TexZK/RATT/README.txt

RATT - Relatively Accurate TurnTable

For information about the project, please refer to:
./doc/reports/Report.pdf
