TexZK/RATT/doc/schematics/README.txt

PDF printings of the electronic schematics and PCB boards.
