TexZK/RATT/src/schematics/README.txt

Source code for PCB schematics, developed with CadSoft EAGLE 6.2.0.

http://www.cadsoftusa.com/eagle/
