TexZK/RATT/src/firmware/README.txt

Firmware source code, for a Microchip PIC18LF14K50.
Developed with MPLAB IDE 8.x, for the Microchip C18 v3.36 compiler.

http://www.microchip.com/mplab

USB library adapted from the "HID Simple Custom Demo" provided with the
Microchip Application Libraries, using the USB Framework v2.9d.

http://www.microchip.com/mal
