TexZK/RATT/tools/hidtrace/README.txt

HID Trace tool taken from the Atomix Virtual DJ wiki.

http://www.virtualdj.com/wiki/ControllerDefinitionHID.html
http://www.virtualdj.com/download/hidtrace.exe
