TexZK/RATT/src/schematics/report/README.txt

Source code for schematics used only inside the technical report.
