TexZK/RATT/src/report/images/ratt_placement.pdf

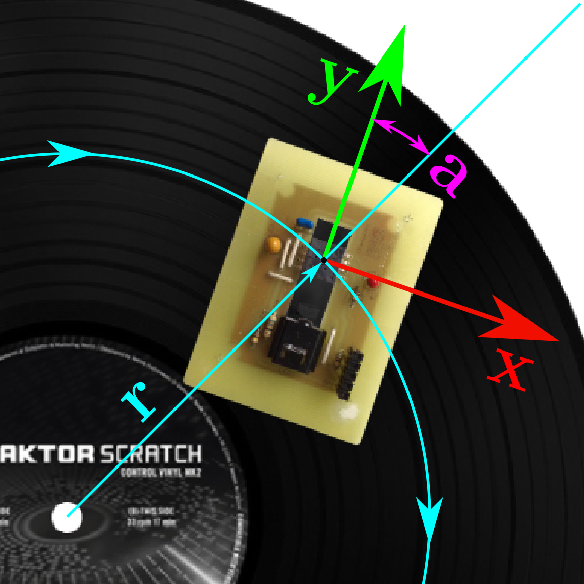
[picture p20: figure]
