TexZK/RATT/src/report/images/computations.xls

Sheet: Computations
Name | Description | Value | Unit
ttDiscDiam | Disc diameter | 12 | in
ttNomAngSpeed | Nominal angular speed | 33 | rot/min
ttPitchOff | Pitch offset | 0.00% | 1%
ttDiscPerim | Disc perimeter | 37.70 | in
ttAngSpeed | Angular speed | 33.00 | rot/min
ttRevRate | Revolution rate | 0.55 | Hz
ttRevTime | Revolution time | 1.82 | s
ttTgSpeed | Tangential speed | 20.73 | in/s
Name | Description | Value | Unit
ssRes | Resolution | 2000 | dot/in
ssMaxSpeed | Maximum speed | 30 | in/s
ssMaxDotRate | Maximum dots rate | 60000 | dot/s
ssMaxDotsOneMs | Maximum dots in 1 ms | 60 | dot
Name | Descritpion | Value | Unit
mmRadius | Radius | 4.00 | in
mmAngleOff | Angle offset | 0 | °
mmRadiusCm | Radius [cm] | 10.16 | cm
mmPerim | Measurement perimeter | 25.13 | in
mmSpeed | Speed | 13.82 | in/s
mmDotRate | Dots rate | 27646.01535 | dot/s
mmRevDots | Revolution dots | 50265.48246 | dot

Sheet: LaTeX data
\newcommand{\ | <-- Head
}{ | <-- Middle
} | <-- Tail
\newcommand{\ttDiscDiam}{ | 12.00 | }
\newcommand{\ttNomAngSpeed}{ | 33.00 | }
\newcommand{\ttPitchOff}{ | 0.00 | }
\newcommand{\ttDiscPerim}{ | 37.70 | }
\newcommand{\ttAngSpeed}{ | 33.00 | }
\newcommand{\ttRevRate}{ | 0.550 | }
\newcommand{\ttRevTime}{ | 1.818 | }
\newcommand{\ttTgSpeed}{ | 20.73 | }
\newcommand{\ssRes}{ | 2000 | }
\newcommand{\ssMaxSpeed}{ | 30 | }
\newcommand{\ssMaxDotRate}{ | 60000 | }
\newcommand{\ssMaxDotsOneMs}{ | 60 | }
\newcommand{\mmRadius}{ | 4.00 | }
\newcommand{\mmAngleOff}{ | 0.00 | }
\newcommand{\mmRadiusCm}{ | 10.16 | }
\newcommand{\mmPerim}{ | 25.13 | }
\newcommand{\mmSpeed}{ | 13.82 | }
\newcommand{\mmDotRate}{ | 27646.01535 | }
\newcommand{\mmRevDots}{ | 50265.48246 | }
