TexZK/RATT/src/report/images/hercules_mp3e2_schematic.jpg

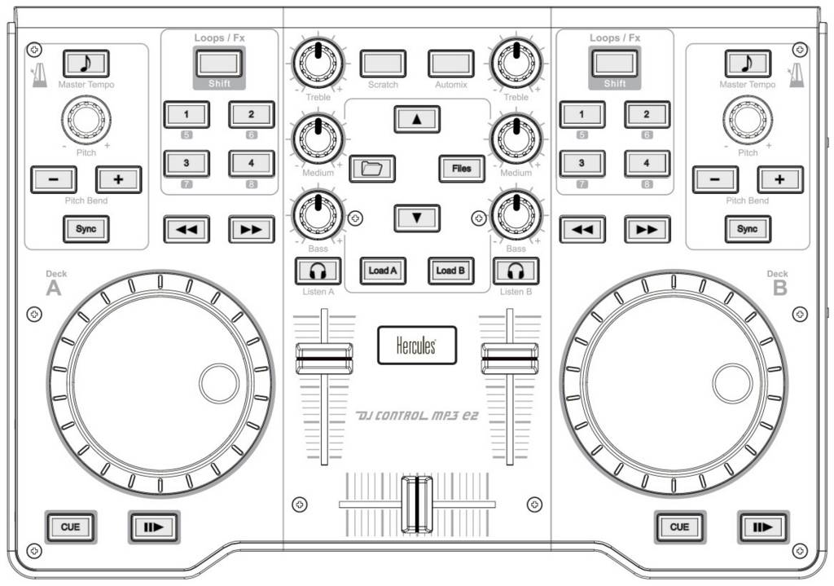
src/report/images/hercules_mp3e2_schematic.jpg
