TexZK/RATT/src/report/images/ratt_placement_merged.png

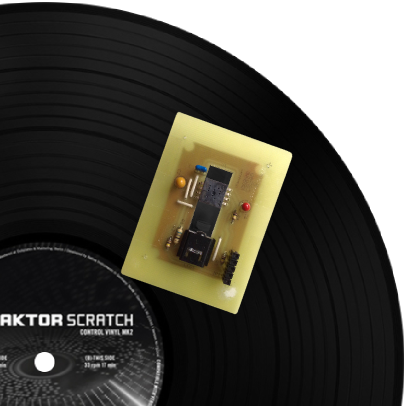
src/report/images/ratt_placement_merged.png
