TexZK/RATT/src/report/images/sensor_photo_float.png

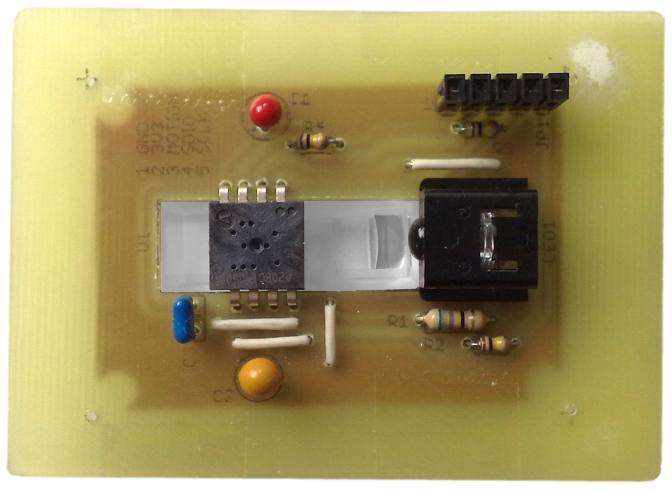
src/report/images/sensor_photo_float.png
