TexZK/RATT/src/report/images/tsp_vinyl.png

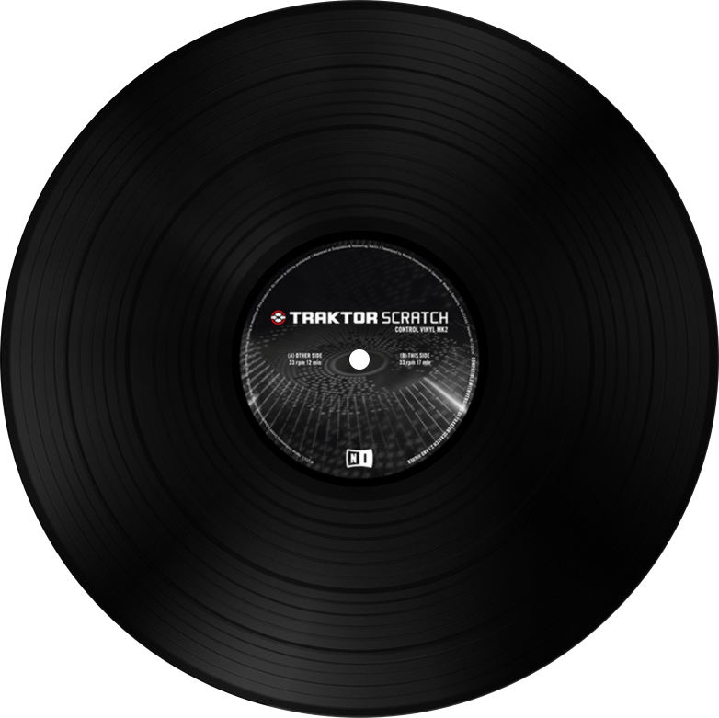
src/report/images/tsp_vinyl.png
