TexZK/RATT/src/report/images/sensor_assembly.pdf

Lens &
mirror

DSP &
controller

LED &
clip

Board

Chassis
