TexZK/RATT/src/report/images/sslsetup.png

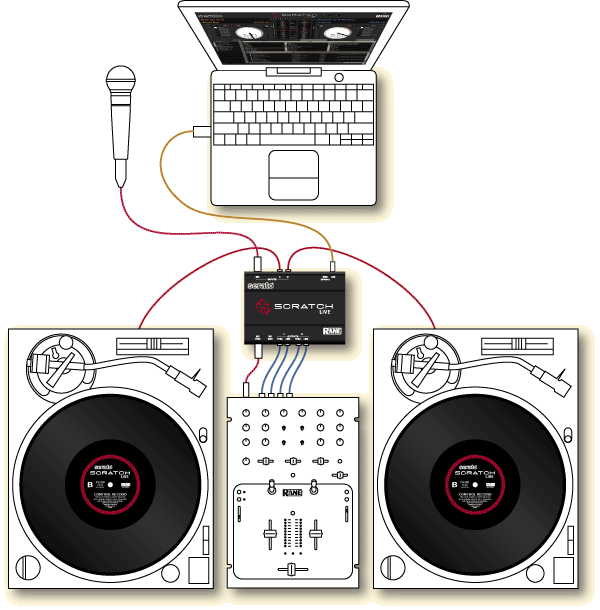
src/report/images/sslsetup.png
