TexZK/RATT/doc/schematics/board_brd.pdf

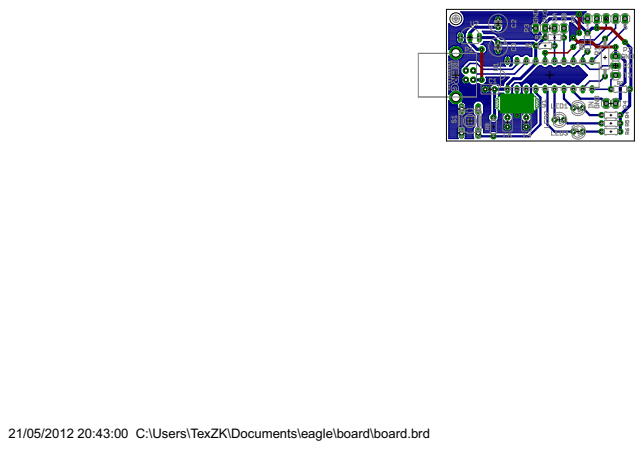
[picture p26: page 1]

21/05/2012 20:43:00 C:\Users\TexZK\Documents\eagle\board\board.brd
