TexZK/RATT/doc/schematics/board_sch.pdf

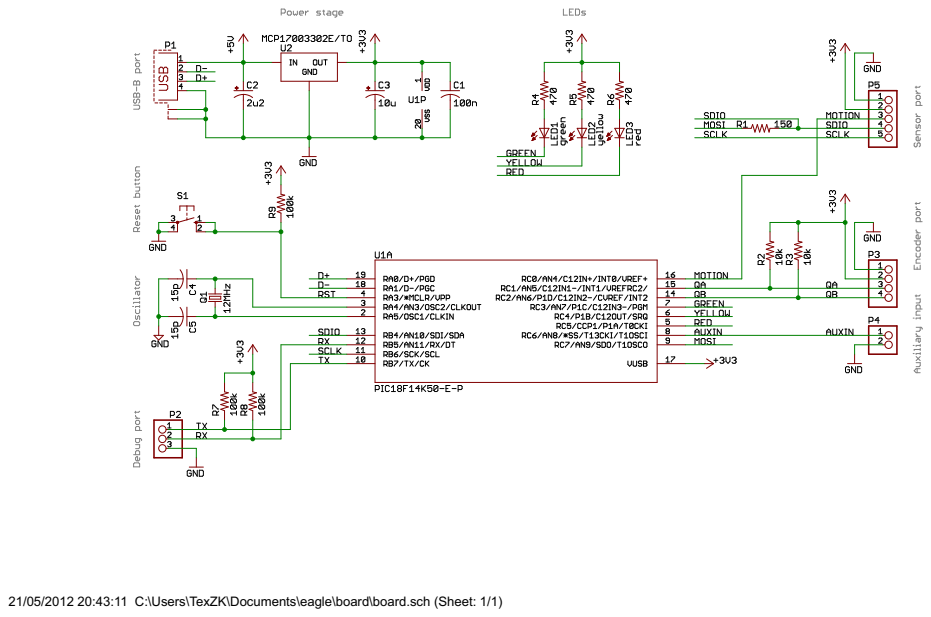
[picture p27: page 1]

21/05/2012 20:43:11 C:\Users\TexZK\Documents\eagle\board\board.sch (Sheet: 1/1)
