TexZK/RATT/doc/schematics/sensor_brd.pdf

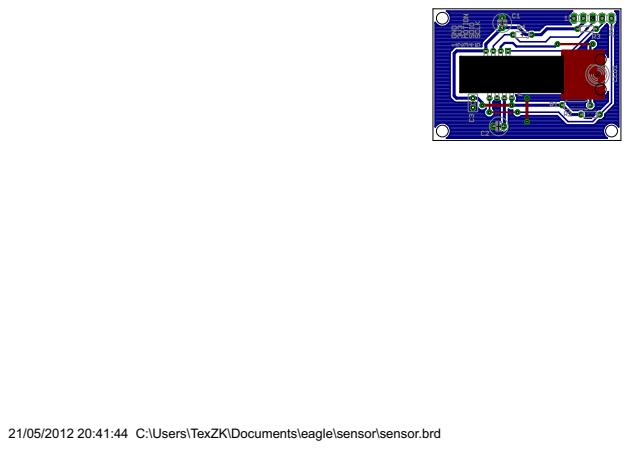
[picture p28: page 1]

21/05/2012 20:41:44 C:\Users\TexZK\Documents\eagle\sensor\sensor.brd
