TexZK/RATT/doc/schematics/sensor_sch.pdf

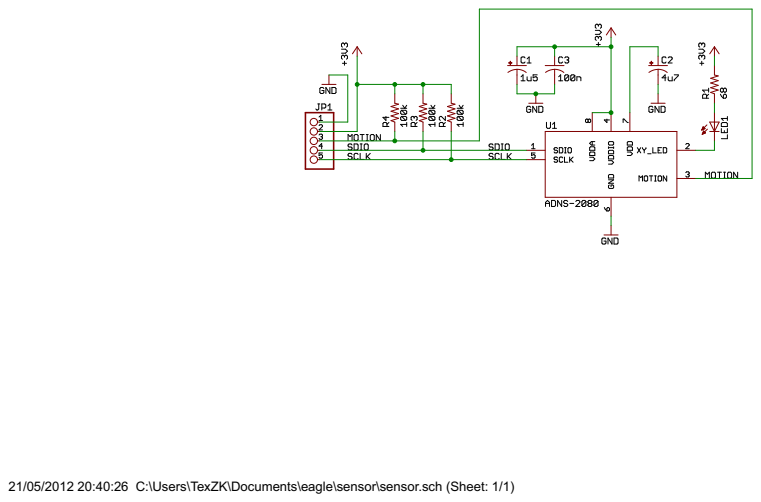
[picture p29: page 1]

21/05/2012 20:40:26 C:\Users\TexZK\Documents\eagle\sensor\sensor.sch (Sheet: 1/1)
