TexZK/RATT/doc/schematics/preamp_brd.pdf

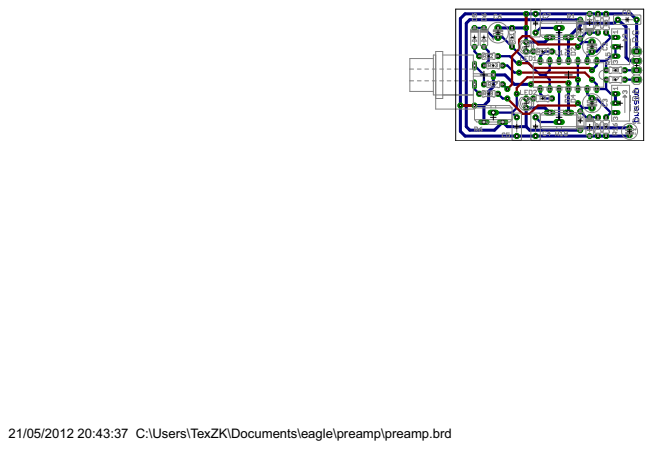
[picture p30: page 1]

21/05/2012 20:43:37 C:\Users\TexZK\Documents\eagle\preamp\preamp.brd
