TexZK/RATT/doc/schematics/preamp_sch.pdf

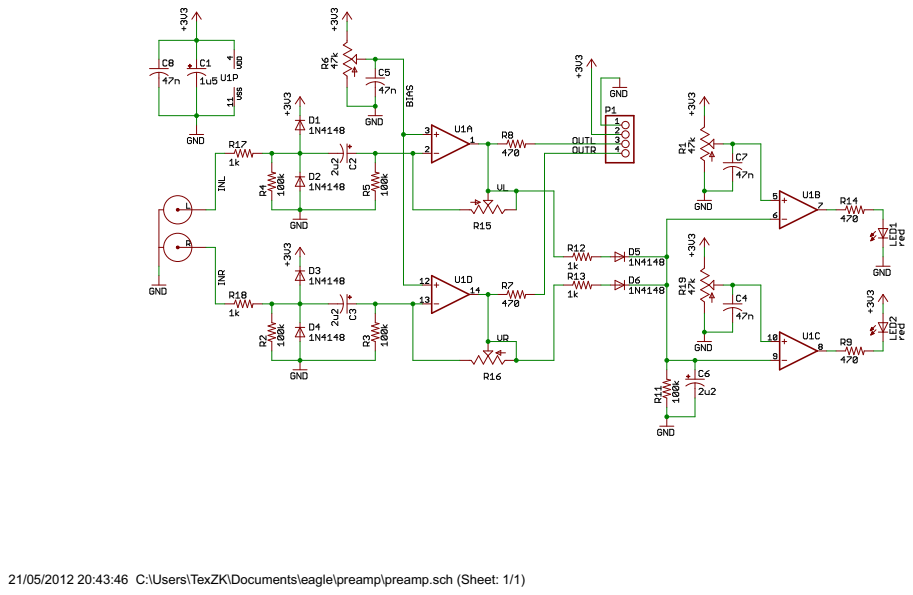
[picture p31: page 1]

21/05/2012 20:43:46 C:\Users\TexZK\Documents\eagle\preamp\preamp.sch (Sheet: 1/1)
