TexZK/RATT/src/report/images/quad_wave.pdf

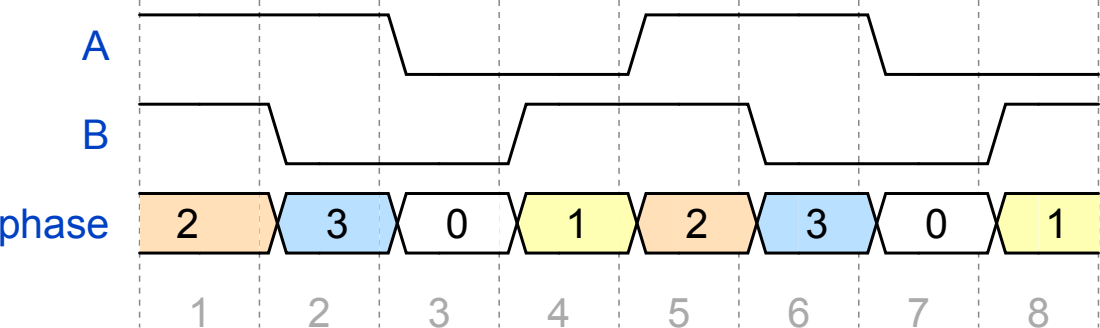
[picture p32: page 1]
phase
