TexZK/RATT/src/schematics/preamp/preamp.brd

## EAGLE design src/schematics/preamp/preamp.brd (2012-03-22)

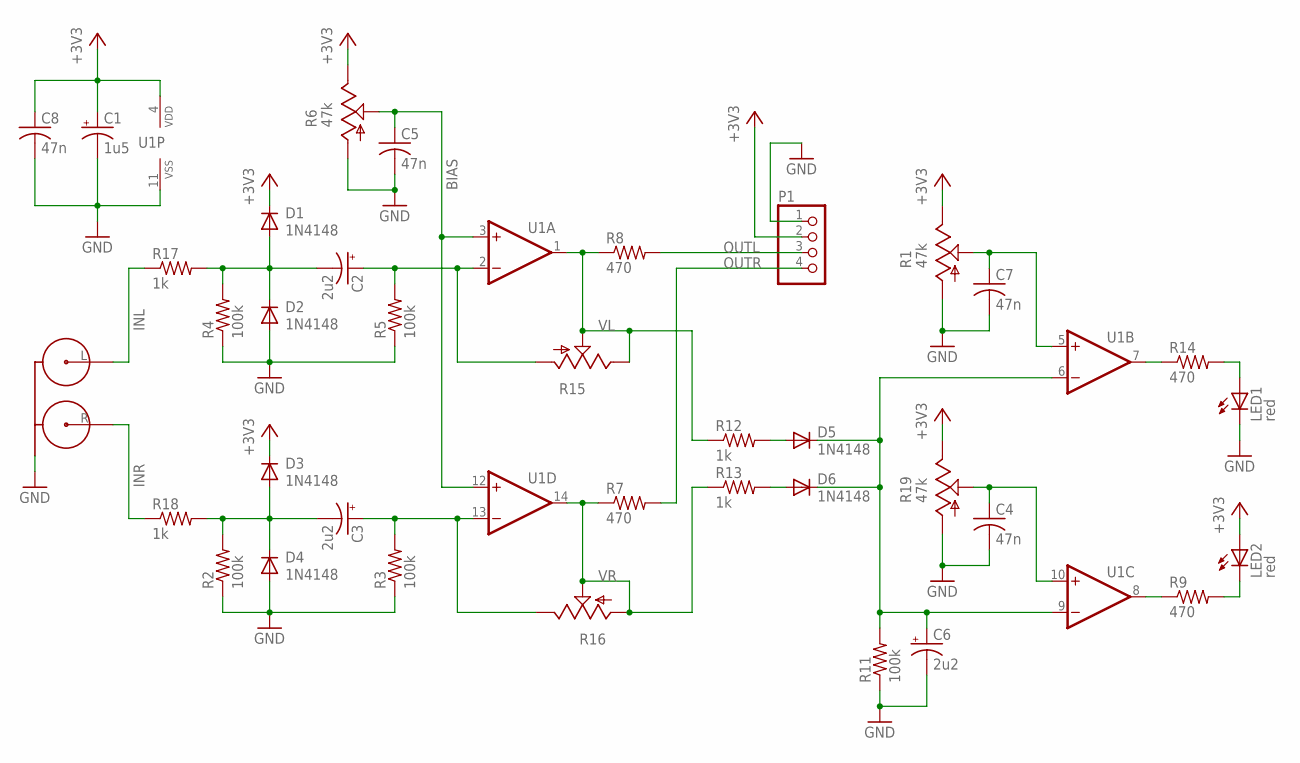
[picture p33: schematic preamp.sch]

Parts:
C1: 1u5; E2-4
C2, C3: 2u2; E2,5-5
C4, C5, C7, C8: 47n; C050-025X075
C6: 2u2; E2,5-6
D1, D2, D3, D4, D5, D6: 1N4148; DO35-5
LED1, LED2: red; LED3MM
P1: PINHD-1X4; 1X04
R1, R6, R19: 47k; PT-10S
R2, R3, R4, R5, R11: 100k; 0204/5
R7, R8, R9, R14: 470; 0204/5
R12, R13, R17, R18: 1k; 0204/5
R15, R16: TRIM_US-S63S; S63S
RCA1: RCA-2V
U1: MCP6024-I/P; DIL14

Connections:
+3V3: C1.+, C8.1, D1.C, D3.C, LED2.A, P1.2, R1.E, R6.E, R19.E, U1.4 (VDD)
BIAS: C5.1, R6.S, U1.3 (+IN), U1.12 (+IN)
GND: C1.-, C4.2, C5.2, C6.-, C7.2, C8.2, D2.A, D4.A, LED1.K (C), P1.1, R1.A, R2.1, R3.1, R4.1, R5.1, R6.A, R11.1, R19.A, RCA1.SHIELD, U1.11 (VSS)
INL: R17.1, RCA1.L
INR: R18.1, RCA1.R
unnamed: C4.1, R19.S, U1.10 (+IN)
unnamed: R9.1, U1.8 (OUT)
unnamed: C3.-, D3.A, D4.C, R2.2, R18.2
unnamed: C6.+, D5.C, D6.C, R11.2, U1.6 (-IN), U1.9 (-IN)
unnamed: C2.+, R5.2, R15.A, U1.2 (-IN)
unnamed: C7.1, R1.S, U1.5 (+IN)
unnamed: LED1.A, R14.2
unnamed: C2.-, D1.A, D2.C, R4.2, R17.2
unnamed: C3.+, R3.2, R16.E, U1.13 (-IN)
unnamed: D5.A, R12.2
unnamed: D6.A, R13.2
unnamed: LED2.K (C), R9.2
unnamed: R14.1, U1.7 (OUT)
OUTL: P1.3, R8.2
OUTR: P1.4, R7.2
VL: R8.1, R12.1, R15.E, R15.S, U1.1 (OUT)
VR: R7.1, R13.1, R16.A, R16.S, U1.14 (OUT)

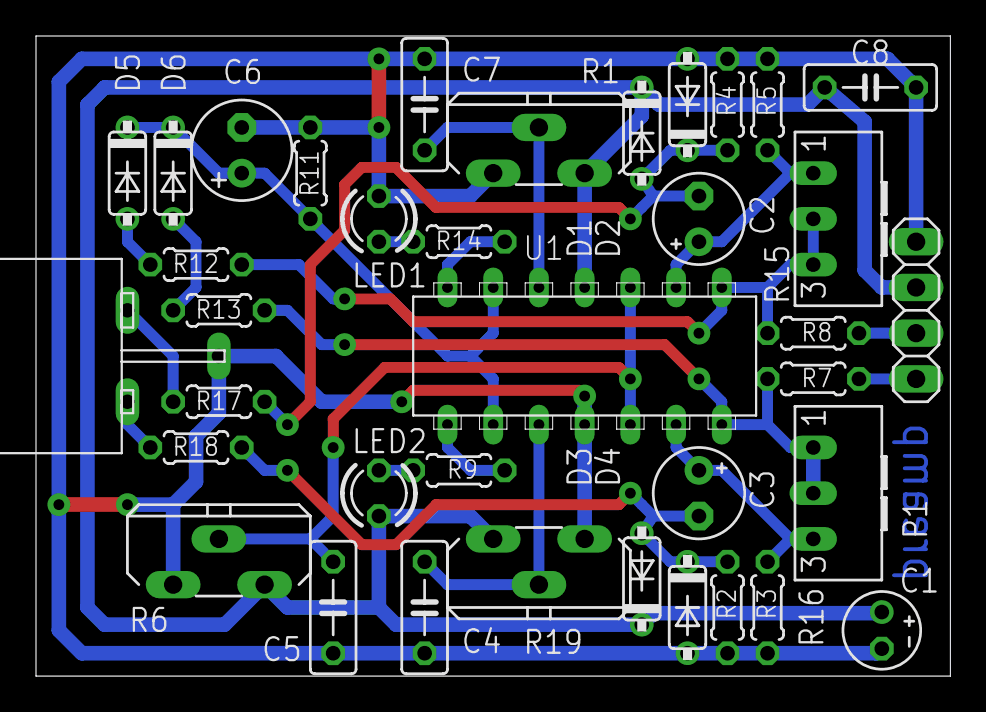
[picture p34: board preamp.brd from above]

Board: 2 copper layers, 50.8 x 35.6 mm, 37 parts (0 on the bottom side), 22 nets.
