TexZK/RATT/src/schematics/board/board.brd

## EAGLE design src/schematics/board/board.brd (2012-03-19)

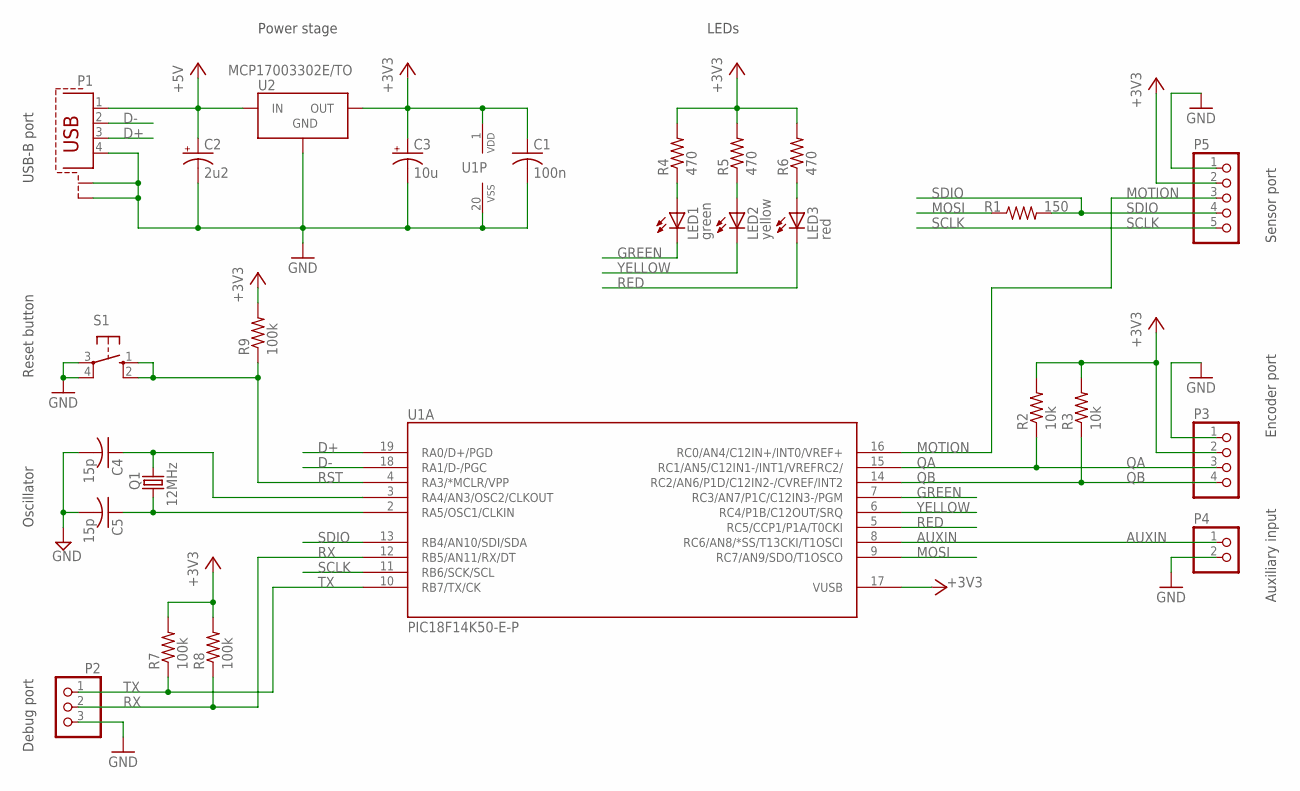
[picture p35: schematic board.sch]

Parts:
C1: 100n; C025-025X050
C2: 2u2; E2-5
C3: 10u; E2-5
C4, C5: 15p; C025-025X050
LED1: green; LED3MM
LED2: yellow; LED3MM
LED3: red; LED3MM
P1: PN61729-S
P2: PINHD-1X3; 1X03
P3: PINHD-1X4; 1X04
P4: PINHD-1X2; 1X02
P5: PINHD-1X5; 1X05
Q1: 12MHz; HC49/S
R1: 150; 0207/10
R2, R3: 10k; 0204/5
R4, R5, R6: 470; 0204/5
R7, R8, R9: 100k; 0204/5
S1: 10-XX; B3F-10XX
U1: PIC18F14K50-E-P; DIL20
U2: MCP17003302E/TO; TO-92

Connections:
+3V3: C1.1, C3.+, P3.2, P5.2, R2.2, R3.2, R4.2, R5.2, R6.2, R7.2, R8.2, R9.2, U1.1 (VDD), U1.17 (VUSB), U2.OUT
+5V: C2.+, P1.1, U2.IN
AUXIN: P4.1, U1.8 (RC6/AN8/*SS/T13CKI/T1OSCI)
D+: P1.3, U1.19 (RA0/D+/PGD)
D-: P1.2, U1.18 (RA1/D-/PGC)
GND: C1.2, C2.-, C3.-, C4.2, C5.2, P1.4, P1.S1, P1.S2, P2.3, P3.1, P4.2, P5.1, S1.3, S1.4 (P1), U1.20 (VSS), U2.GND
GREEN: LED1.K (C), U1.7 (RC3/AN7/P1C/C12IN3-/PGM)
MOSI: R1.1, U1.9 (RC7/AN9/SDO/T1OSCO)
MOTION: P5.3, U1.16 (RC0/AN4/C12IN+/INT0/VREF+)
unnamed: LED3.A, R6.1
unnamed: C4.1, Q1.1, U1.3 (RA4/AN3/OSC2/CLKOUT)
unnamed: C5.1, Q1.2, U1.2 (RA5/OSC1/CLKIN)
unnamed: LED2.A, R5.1
unnamed: LED1.A, R4.1
QA: P3.3, R2.1, U1.15 (RC1/AN5/C12IN1-/INT1/VREFRC2/)
QB: P3.4, R3.1, U1.14 (RC2/AN6/P1D/C12IN2-/CVREF/INT2)
RED: LED3.K (C), U1.5 (RC5/CCP1/P1A/T0CKI)
RST: R9.1, S1.1 (S), S1.2 (S1), U1.4 (RA3/*MCLR/VPP)
RX: P2.2, R8.1, U1.12 (RB5/AN11/RX/DT)
SCLK: P5.5, U1.11 (RB6/SCK/SCL)
SDIO: P5.4, R1.2, U1.13 (RB4/AN10/SDI/SDA)
TX: P2.1, R7.1, U1.10 (RB7/TX/CK)
YELLOW: LED2.K (C), U1.6 (RC4/P1B/C12OUT/SRQ)

Notes on the sheet:
Reset button
Oscillator
Debug port
USB-B port
Encoder port
Auxiliary input
Sensor port
Power stage
LEDs

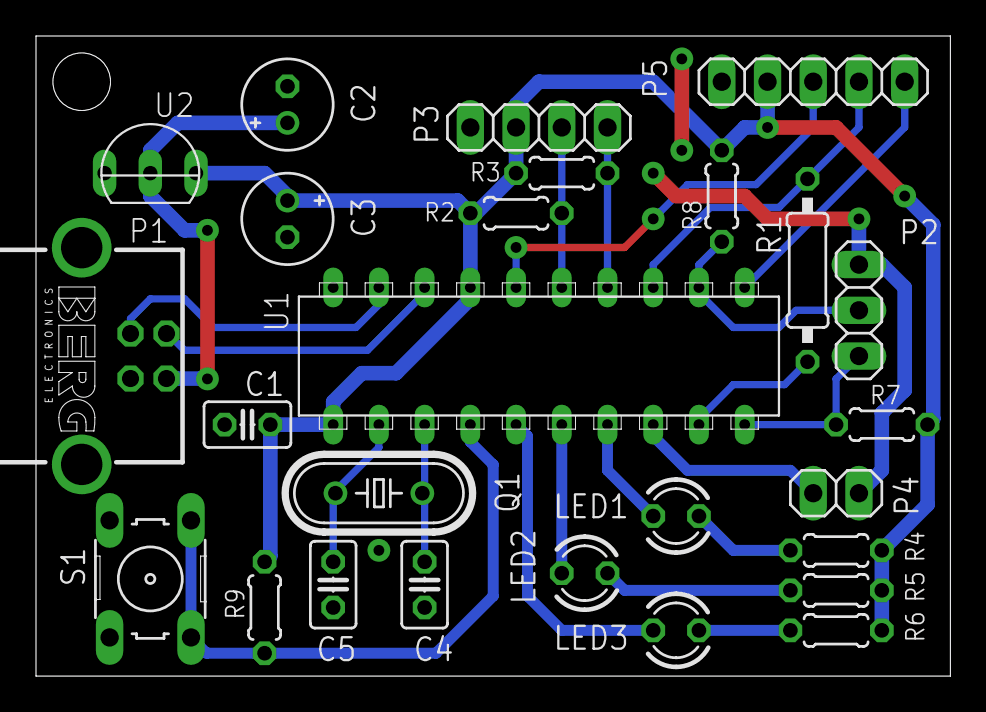
[picture p36: board board.brd from above]

Board: 2 copper layers, 50.8 x 35.6 mm, 26 parts (0 on the bottom side), 23 nets.
