TexZK/RATT/src/schematics/sensor/sensor.brd

## EAGLE design src/schematics/sensor/sensor.brd (2012-03-18)

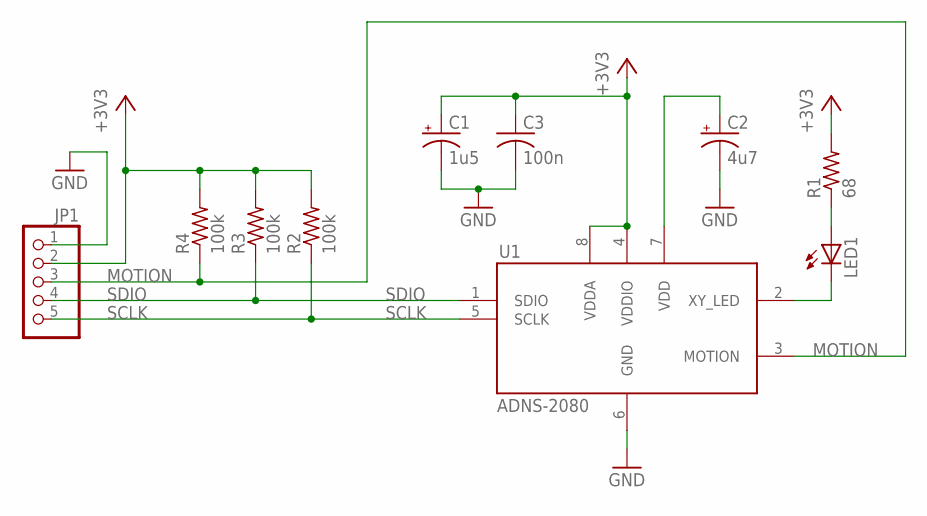
[picture p37: schematic sensor.sch]

Parts:
C1: 1u5; E2,5-5
C2: 4u7; E2,5-5
C3: 100n; C025-025X050
JP1: PINHD-1X5; 1X05
LED1: LED5MM
R1: 68; 0207/7
R2, R3, R4: 100k; 0204/5
U1: ADNS-2080; DIP8-OPTICAL

Connections:
+3V3: C1.+, C3.1, JP1.2, R1.2, R2.2, R3.2, R4.2, U1.4 (VDDIO), U1.8 (VDDA)
GND: C1.-, C2.-, C3.2, JP1.1, U1.6 (GND)
MOTION: JP1.3, R4.1, U1.3 (MOTION)
unnamed: C2.+, U1.7 (VDD)
unnamed: LED1.A, R1.1
unnamed: LED1.K (C), U1.2 (XY_LED)
SCLK: JP1.5, R2.1, U1.5 (SCLK)
SDIO: JP1.4, R3.1, U1.1 (SDIO)

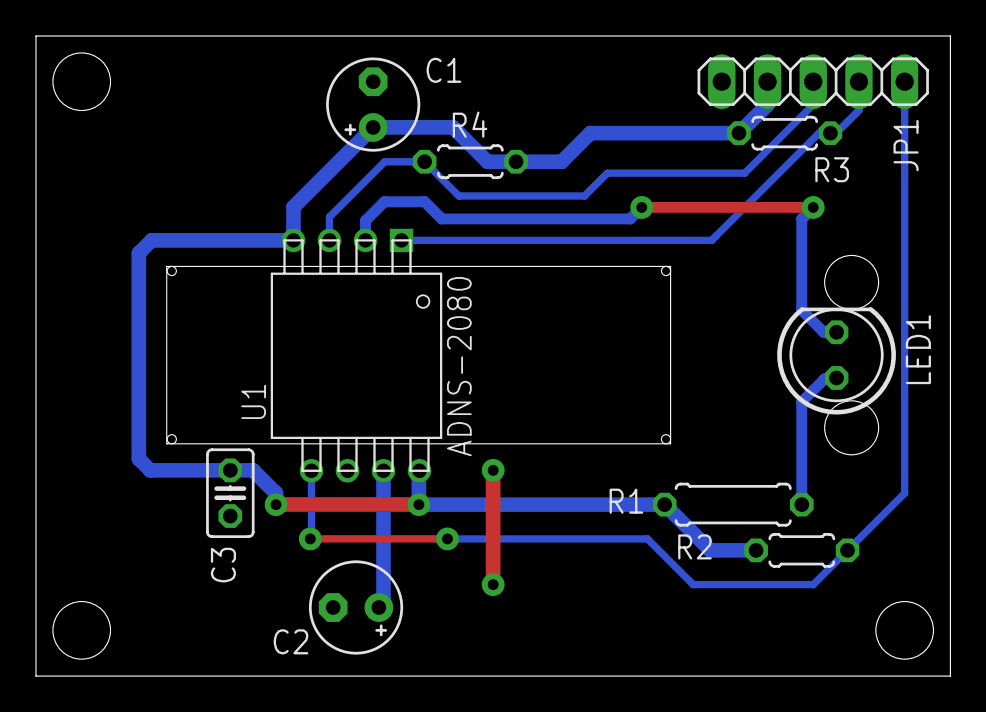
[picture p38: board sensor.brd from above]

Board: 2 copper layers, 50.8 x 35.6 mm, 10 parts (0 on the bottom side), 8 nets.
