TexZK/RATT/src/firmware/src/debug.c

/**
 * PAN3101DB library.
 *
 * This file contains the debug functions, so that messages are sent through
 * the UART port.
 *
 * @author Andrea "TexZK" Zoppi
 *
 */

//\\//\\//\\//\\//\\//\\//\\//\\//\\//\\//\\//\\//\\//\\//\\//\\//\\//\\//\\//
// CONFIGURATION

//#define	DISABLE_THIS_MODULE


//\\//\\//\\//\\//\\//\\//\\//\\//\\//\\//\\//\\//\\//\\//\\//\\//\\//\\//\\//
// HEADERS

#include "Compiler.h"
#include "app.h"

#include "debug.h"
#if defined(DISABLE_THIS_MODULE) && !defined(DONT_USE_DEBUG_CONSOLE)
#define	DONT_USE_DEBUG_CONSOLE
#endif


//\\//\\//\\//\\//\\//\\//\\//\\//\\//\\//\\//\\//\\//\\//\\//\\//\\//\\//\\//
// LOCAL DEFINITIONS
#pragma udata data_debug_local

// Baud rate generation
#define	SPBRG_16BITS		0								/// Use a 16-bits counter for BRG
#define	SPBRG_HISPEED		0								/// Use high-speed BRG
#define	SPBRG_SCALE			(						\
	(!SPBRG_16BITS && !SPBRG_HISPEED) ? 64 :		\
	((SPBRG_16BITS != SPBRG_HISPEED) ? 16 : 4) )			/// Divider scale for BRG (automatically determined)
#define	SPBRG_VALUE			((SYS_FOSC / (DEBUG_BAUD_RATE * SPBRG_SCALE)) - 1)	/// SPBRG value

#define	EnableTxInt()		{ DEBUG_UART_INT_TX = 1; }		/// Enables the TX interrupt
#define	DisableTxInt()		{ DEBUG_UART_INT_TX = 0; }		/// Disables the RX interrupt

#define	EnableRxInt()		{ DEBUG_UART_INT_RX = 1; }		/// Enables the TX interrupt
#define	DisableRxInt()		{ DEBUG_UART_INT_RX = 0; }		/// Disables the RX interrupt


//\\//\\//\\//\\//\\//\\//\\//\\//\\//\\//\\//\\//\\//\\//\\//\\//\\//\\//\\//
// LOCAL VARIABLES
#pragma udata data_debug_local

volatile DEBUG_UART_BUFFER_INDEX_TYPE	debug_uartTxBufferHead;
volatile DEBUG_UART_BUFFER_INDEX_TYPE	debug_uartTxBufferTail;
volatile unsigned char					debug_uartTxBufferFree;

volatile DEBUG_UART_BUFFER_INDEX_TYPE	debug_uartRxBufferHead;
volatile DEBUG_UART_BUFFER_INDEX_TYPE	debug_uartRxBufferTail;
volatile unsigned char					debug_uartRxBufferFree;

#pragma udata data_debug_txbuf
volatile char							debug_uartTxBufferData[ DEBUG_TX_BUFFER_SIZE ];

#pragma udata data_debug_rxbuf
volatile char							debug_uartRxBufferData[ DEBUG_RX_BUFFER_SIZE ];


//\\//\\//\\//\\//\\//\\//\\//\\//\\//\\//\\//\\//\\//\\//\\//\\//\\//\\//\\//
// GLOBAL VARIABLES
#pragma udata data_debug_global


//\\//\\//\\//\\//\\//\\//\\//\\//\\//\\//\\//\\//\\//\\//\\//\\//\\//\\//\\//
// LOCAL PROTOTYPES
#pragma code code_debug_local


//\\//\\//\\//\\//\\//\\//\\//\\//\\//\\//\\//\\//\\//\\//\\//\\//\\//\\//\\//
// LOCAL FUNCTIONS
#pragma code code_debug_local


//\\//\\//\\//\\//\\//\\//\\//\\//\\//\\//\\//\\//\\//\\//\\//\\//\\//\\//\\//
// GLOBAL FUNCTIONS
#pragma code code_debug_global

void Debug_Initialize( void )
{
	Debug_Release();			// Release the module
	
	// Configure the UART module
	RCSTA = 0;					// Reset the receiver configuration
	RCSTAbits.CREN = 1;			// Receive continuously
	
	TXSTA = 0;					// Reset the transmitter configuration
	TXSTAbits.TXEN = 1;			// Enable the transmitter
	
	BAUDCON = 0;
	TXSTAbits.BRGH = 0;			// No need for high-speed debug @ 38400 baud
	BAUDCONbits.BRG16 = 0;		// Use a 8-bits counter
	SPBRG = SPBRG_VALUE;		// Baud rate generator counter
	SPBRGH = SPBRG_VALUE >> 8;
	
	IPR1bits.TXIP = 0;			// Low-priority interrupts
	IPR1bits.RCIP = 0;
	
	RCSTAbits.SPEN = 1;			// Enable the serial port
	INTCONbits.GIEH = 1;		// Enable interrupts
    INTCONbits.GIEL = 1;
    
#ifndef	DONT_USE_DEBUG_CONSOLE
	// Print a welcome message
	Debug_PrintRom_( "=> MOUSE SENSOR HID CONTROLLER <=" );
    Debug_PrintConst_NewLine();
    Debug_PrintConst_NewLine();
	
	// Print some info
    Debug_PrintConst_Initializing();
    Debug_PrintRom_( "UART" );
    Debug_PrintConst_Dots();
    Debug_PrintConst_NewLine();
    
    Debug_PrintRom_( "\tSPBRG" );
    Debug_PrintConst_Eq();
    Debug_PrintConst_0x();
    Debug_PrintHex( SPBRGH );
    Debug_PrintHex( SPBRG );
    Debug_PrintConst_NewLine();
    
    Debug_PrintConst_Dots();
    Debug_PrintConst_Ok();
    Debug_PrintConst_NewLine();
#endif
}

	
void Debug_Release( void )
{
	Debug_Truncate();			// Free the buffers
	DisableTxInt();				// Disable interrupts
	DisableRxInt();
	RCSTAbits.SPEN = 0;			// Turn the UART off
}


#ifdef	USE_DEBUG_PRINT_ROM
void Debug_PrintRom( const far rom char * text )
{
	while ( *text ) {
		Debug_PrintChar( *text );
		++text;
	}
}
#endif


#ifdef	USE_DEBUG_PRINT_RAM
void Debug_PrintRam( const far ram char * text )
{
	while ( *text ) {
		Debug_PrintChar( *text );
		++text;
	}
}
#endif


void Debug_PrintChar( char value )
{
	DisableTxInt();
#ifndef	DONT_USE_DEBUG_CONSOLE
	App_Lock();
	if ( debug_uartTxBufferFree == DEBUG_TX_BUFFER_SIZE && DEBUG_UART_FLAG_TX ) {
		// SW & HW buffers are free, send directly to the USART
		TXREG = value;
	}
	else {
		// Check if buffer is full
		if ( debug_uartTxBufferFree == 0 ) {
			while ( !DEBUG_UART_FLAG_TX );		// Block until a character is sent (mandatory!)
			TXREG = debug_uartTxBufferData[ debug_uartTxBufferHead ];
			if ( ++debug_uartTxBufferHead >= DEBUG_TX_BUFFER_SIZE ) {
				debug_uartTxBufferHead = 0;
			}
			++debug_uartTxBufferFree;
		}
		// Enqueue the new character
		--debug_uartTxBufferFree;
		debug_uartTxBufferData[ debug_uartTxBufferTail ] = value;
		if ( ++debug_uartTxBufferTail >= DEBUG_TX_BUFFER_SIZE ) {
			debug_uartTxBufferTail = 0;
		}
		EnableTxInt();		// Further data to process
	}
	App_Unlock();
#endif
}


#ifdef	USE_DEBUG_PRINT_HEX
void Debug_PrintHex( unsigned char value )
{
	unsigned char c = (value >> 4) & 0x0F;
	Debug_PrintChar( c + ((c >= 10) ? ('A' - 10) : '0') );
	c = value & 0x0F;
	Debug_PrintChar( c + ((c >= 10) ? ('A' - 10) : '0') );
}
#endif


#ifdef	USE_DEBUG_PRINT_U8
void Debug_PrintU8( unsigned char value )
{
	unsigned char quotient;
	if ( value >= 100 ) {
		for ( quotient = 0; value >= 100; value -= 100, ++quotient );
		Debug_PrintChar( quotient + '0' );
	}
	if ( value >= 10 ) {
		for ( quotient = 0; value >= 10; value -= 10, ++quotient );
		Debug_PrintChar( quotient + '0' );
	}
	Debug_PrintChar( value + '0' );
}
#endif


#ifdef	USE_DEBUG_PRINT_U16
void Debug_PrintU16( unsigned short value )
{
	unsigned short quotient;
	if ( value >= 10000 ) {
		for ( quotient = 0; value >= 10000; value -= 10000, ++quotient );
		Debug_PrintChar( quotient + '0' );
	}
	if ( value >= 1000 ) {
		for ( quotient = 0; value >= 1000; value -= 1000, ++quotient );
		Debug_PrintChar( quotient + '0' );
	}
	Debug_PrintU8( value );
}
#endif


#ifdef	USE_DEBUG_PRINT_S8
void Debug_PrintS8( signed char value )
{
	unsigned char quotient;
	if ( value == -128 ) {
		Debug_PrintChar( '-' );
		Debug_PrintChar( '1' );
		Debug_PrintChar( '2' );
		Debug_PrintChar( '8' );
		return;
	}
	else if ( value < 0 ) {
		value = -value;
		Debug_PrintChar( '-' );
	}
	Debug_PrintU8( (unsigned char)value );
}
#endif


#ifdef	USE_DEBUG_PRINT_S16
void Debug_PrintS16( signed short value ) {
	if ( value == -32768 ) {
		Debug_PrintRom_( "-32768" );
		return;
	}
	else if ( value < 0 ) {
		value = -value;
		Debug_PrintChar( '-' );
	}
	Debug_PrintU16( (unsigned short)value );
}
#endif


DEBUG_UART_BUFFER_INDEX_TYPE Debug_TxBufferUsed( void )
{
	return DEBUG_TX_BUFFER_SIZE - debug_uartTxBufferFree;
}


DEBUG_UART_BUFFER_INDEX_TYPE Debug_TxBufferFree( void )
{
	return debug_uartTxBufferFree;
}


DEBUG_UART_BUFFER_INDEX_TYPE Debug_RxBufferUsed( void )
{
	return DEBUG_TX_BUFFER_SIZE - debug_uartRxBufferFree;
}


DEBUG_UART_BUFFER_INDEX_TYPE Debug_RxBufferFree( void )
{
	return debug_uartRxBufferFree;
}


void Debug_Truncate( void )
{
	DisableTxInt();
	App_Lock();
	debug_uartTxBufferHead = 0;
	debug_uartTxBufferTail = 0;
	debug_uartTxBufferFree = DEBUG_TX_BUFFER_SIZE;
	App_Unlock();
}

	
void Debug_Flush( void )
{
#ifndef	DONT_USE_DEBUG_CONSOLE
	DisableTxInt();
	App_Lock();
	while ( debug_uartTxBufferFree < DEBUG_TX_BUFFER_SIZE ) {
		while ( !DEBUG_UART_FLAG_TX );
		TXREG = debug_uartTxBufferData[ debug_uartTxBufferHead ];
		if ( ++debug_uartTxBufferHead >= DEBUG_TX_BUFFER_SIZE ) {
			debug_uartTxBufferHead = 0;
		}
		++debug_uartTxBufferFree;
		App_Unlock();
		App_Lock();
	}
	debug_uartTxBufferHead = 0;
	debug_uartTxBufferTail = 0;
	debug_uartTxBufferFree = DEBUG_TX_BUFFER_SIZE;
	App_Unlock();
#else
	Debug_Truncate();
#endif
}


void Debug_TxIntCallback( void )
{
	// Send the next character
	DisableTxInt();
#ifndef	DONT_USE_DEBUG_CONSOLE
	App_Lock();
	if ( debug_uartTxBufferFree < DEBUG_TX_BUFFER_SIZE ) {
		while ( !DEBUG_UART_FLAG_TX );		// Should always be true
		TXREG = debug_uartTxBufferData[ debug_uartTxBufferHead ];
		if ( ++debug_uartTxBufferHead >= DEBUG_TX_BUFFER_SIZE ) {
			debug_uartTxBufferHead = 0;
		}
		++debug_uartTxBufferFree;
		
		// Enable the interrupt if there are queued characters
		if ( debug_uartTxBufferFree < DEBUG_TX_BUFFER_SIZE ) {
			EnableTxInt();
		}
	}
	App_Unlock();
#endif
}


void Debug_RxIntCallback( void )
{
	volatile unsigned char dummy;
	dummy = RCREG;					// Just drop the byte
}


#ifdef	USE_DEBUG_PRINTCONST_PLACEHOLDER
void Debug_PrintPlaceholder( void )
{
	Debug_PrintChar( '#' );
}
#endif


#ifdef	USE_DEBUG_PRINTCONST_NEWLINE
void Debug_PrintConst_NewLine( void )
{
	Debug_PrintChar( '\r' );
	Debug_PrintChar( '\n' );
}
#endif


#ifdef	USE_DEBUG_PRINTCONST_INITIALIZING
void Debug_PrintConst_Initializing( void )
{
	Debug_PrintRom_( "Initializing " );
}
#endif


#ifdef	USE_DEBUG_PRINTCONST_CHECKING
void Debug_PrintConst_Checking( void )
{
	Debug_PrintRom_( "Checking " );
}
#endif


#ifdef	USE_DEBUG_PRINTCONST_EVENTBEGIN
void Debug_PrintConst_EventBegin( void )
{
	Debug_PrintChar( '[' );
	Debug_PrintChar( '@' );
}
#endif


#ifdef	USE_DEBUG_PRINTCONST_EVENTEND
void Debug_PrintConst_EventEnd( void )
{
	Debug_PrintChar( ']' );
}
#endif


#ifdef	USE_DEBUG_PRINTCONST_DOTS
void Debug_PrintConst_Dots( void )
{
	Debug_PrintChar( '.' );
	Debug_PrintChar( '.' );
	Debug_PrintChar( '.' );
	Debug_PrintChar( ' ' );
}
#endif


#ifdef	USE_DEBUG_PRINTCONST_OK
void Debug_PrintConst_Ok( void )
{
	Debug_PrintChar( 'o' );
	Debug_PrintChar( 'k' );
}
#endif


#ifdef	USE_DEBUG_PRINTCONST_FAIL
void Debug_PrintConst_Fail( void )
{
	Debug_PrintChar( 'F' );
	Debug_PrintChar( 'A' );
	Debug_PrintChar( 'I' );
	Debug_PrintChar( 'L' );
}
#endif


#ifdef	USE_DEBUG_PRINTCONST_EQ
void Debug_PrintConst_Eq( void )
{
	Debug_PrintChar( ' ' );
	Debug_PrintChar( '=' );
	Debug_PrintChar( ' ' );
}
#endif


#ifdef	USE_DEBUG_PRINTCONST_0X
void Debug_PrintConst_0x( void )
{
	Debug_PrintChar( '0' );
	Debug_PrintChar( 'x' );
}
#endif



// EOF
