TexZK/RATT/(commit log)

2012-03-09 Regulator datasheet and WIP PCB drafts
    Added Microchip MCP1700 voltage regulator datasheet.
    Added work-in-progress Eagle schematics and PCB drawings for both the
    main board and the sensor module. The sensor PCB should be already
    correct.
    Andrea Zoppi
    [board.sch, sensor.brd, sensor.sch]
2012-03-10 Sensor PCB updates
    Minor changes to the sensor module PCB layout.
    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
    [sensor.brd, sensor.sch]
2012-03-10 Main board PCB draft
    Added a draft of the main board PCB.
    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
    [board.sch]
2012-03-10 PCBs updated
    Minor changes were done to both the main board and sensor module PCB
    layouts.
    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
    [board.brd, board.sch]
2012-03-10 Added firmware skeleton
    The firmware skeleton is beign developed. It is based on Microchip
    Application Library, USB Devicr - HID Simple Custom Demo.
    The skeleton is still work-in-progress, but a basic (yet not functional)
    driver for the ADNS-2080 was written, and an UART "debug/printer" module
    is planned.
    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
2012-03-11 Small fixes to firmware
    A bootloader definitions file was modularized, and a few initialization
    routines were rearranged (just some refactoring).
    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
    [app.c, app.h, bootloader.h]
2012-03-11 HID bootloader
    A HID bootloader project was added. It is basically the HID bootloader
    provided by Microchip (Low Pin Count USB Development Kit), with LED
    definitions modified according to the actual PCB layout.
    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
2012-03-11 Added UART pull-ups
    Added pull-ups to the UART port, so that there are never mistaken signals.
    They are not critical, but may help in keeping consistent values,
    especially for the receiver.
    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
    [board.brd, board.sch]
2012-03-12 Hand-written UART functions
    UART functions are now hand-written, because library functions provided by
    Microchip don't always work properly.
    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
2012-03-12 Hand-written SPI code
    SPI functions were ported by hand, so that the code behaves exactly as
    expected.
    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
2012-03-12 Improved debug info of ADNS module
    The yellow LED is used to see if there is some buffered motion, ready to
    be sent over USB.
    Macros with integrated pointer casting were added, so that literal strings
    can be written without manual casting each time.
    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
2012-03-12 Static HID report data
    HID report construction is now done on a static variable, so that the
    report ID can be tracked (may become a timestamp in the future).
    Small fixes done.
    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
    [adns2080.c, adns2080.h]
2012-03-12 Debug console now working properly
    It is possible to send characters properly over the UART console.
    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
2012-03-12 Bootloader LEDs updated
    LED are now working properly in the bootloader.
    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
2012-03-13 Added user button pull-up
    A pull-up resistor was added to the user button, because the built-in weak
    pull-up of the MCU does not work properly at power-up.
    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
    [board.brd, board.sch]
2012-03-13 Fine-grained ADNS time base
    The ADNS SCLK time base is now controlled by the Timer 2 output, at
    TMR2_output/2 trigger. This makes a flexible SCLK assignment, controlled
    by the PR2 register. With a fixed time base it is only possible to get a
    750 kHz clock at 48 MHz oscillator.
    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
    [adns2080.c, adns2080.h]
2012-03-13 Improved debug messaging system
    The debug console is now interrupt-driven.
    Some common strings can be called through dedicated Debug_PrintConst_*
    calls, so that ROM memory occupation is minimized.
    USB state changes are now notified through [!USB_<state>] event messages.
    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
2012-03-13 Fixed ADNS communication issues
    The SCLK frequency is now correct (1 MHz).
    Since SDIO is a bidirectional signal, the MOSI pin has to be set to HiZ
    properly when the slave (ADNS-2080) is about to drive it. This should work
    the right way now.
    Other definitions and small fixes were applied.
    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
    [adns2080.c, adns2080.h, app.c]
2012-03-14 Minor PCB fixes
    Changed resistor values so that performance is improved, and the PIC
    inputs can read correct pull-up values.
    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
    [board.brd, board.sch, sensor.brd, sensor.sch]
2012-03-15 PIC SPI silicon bug workaround
    The PIC used for prototyping is affected by the bug 2.1 described inside
    the Microchip document #DS80411E, which causes a short first clock pulse
    over SCLK.
    The workaround "Option 2" was applied in order to fix misleading
    behaviors.
    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
    [adns2080.c, adns2080.h]
2012-03-15 Fixed missing R/W bit in address writing
    The MSb indicating a Write/Read operation on that register was missing,
    and has been added to ADNS register write/read function calls.
    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
    [adns2080.c, adns2080.h]
2012-03-15 SPI bug workaround applied to read operations
    The SPI bug which affected commit ba346832ebf448db90499e791d85ebcc437bceb5
    was fixed only for write operations. It is now fixed also for read
    operations.
    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
    [adns2080.c]
2012-03-15 MOSI held in HiZ after reading
    The MOSI pin must be kept in HiZ state after finishing a write, because
    the SDIO line is still driven by ADNS-2080 until the next falling edge of
    SCLK.
    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
2012-03-15 Fixed input pins as digital
    On reset, all pins are analog by default. When reading the digital value,
    it always returns 0. So, only RC6/AN8 is left as analog input (AUX), while
    all the other well-known digital inputs are digital and can be read
    correctly.
    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
    [app.c]
2012-03-15 Improved debug messages
    Hex byte nibbles are printed in the right order (high nibble, low nibble).
    Events now use '@' instead of '!' to avoid misleading interpretation as
    NOT operator ("[@EVENT]" instead of "[!EVENT]").
    Misc fixes.
    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
    [debug.c, debug.h]
2012-03-15 Improved setup debug text
    Added more checks and debug info text printed to the debug console.
    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
2012-03-15 Automatic console flush and cleaner button timing
    The debug console is automatically flushed at each background task cycle.
    The user button is debounced with a cleader code.
    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
2012-03-15 Fixed Motion Burst operations
    The Motion burst did not leave the SDIO line driven by ADNS after reading
    values; it is fixed now.
    Also, the values been read were completely messed up. It is now possible
    to read 12-bits values and convert them into 16-bits signed integers.
    Other small changes, just for readability.
    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
    [adns2080.c, adns2080.h]
2012-03-16 Added incremental encoder template code
    An incremental encoder software module was added to the firmware project.
    It is not implemented yet.
    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
2012-03-16 Analog incremental encoder pins and aux input
    The incremental encoder pins and the auxiliary input are now initialized
    as analog inputs.
    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
2012-03-16 Encoder interrupts as macros
    Incremental encoder interrupts are handled by macros instead of
    procedures, to improve latency when called.
    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
2012-03-16 Comparator interrupts defined
    Interrupts for comparators were defined and integrated with the main
    application of the firmware.
    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
2012-03-16 Fixed MOTION interrupt definitions
    Interrupt definitions relative to the MOTION signal are now moved to INT0.
    Other definitions have been fixed as well.
    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
    [adns2080.c, adns2080.h]
2012-03-16 Incremental encoder and MOTION pins updated
    Pins for incremental encoder signals (ENC_A and ENC_B), and the MOTION
    signal have ben re-routed to the correct PIC pins, according to the
    changes made in the latest commits.
    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
    [board.brd, board.sch]
2012-03-16 Encoder initialization completed
    The incremental encoder initialization is now complete. It sets up the
    internal DAC positive voltage references of the two comparators, and the
    comparators themselves.
    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
2012-03-16 Encoder interrupts implemented
    Incremental encoder interrupts were implemented. They increment/decrement
    the delta accumulator. After reading it, it is cleared.
    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
2012-03-18 Fixed PCB libraries
    Some components in the extended Microxhip library had wrong dual-in-line
    package drawings.
    The libraries were renamed as "local" instead of "extended".
    Minor fixes in both schematics and PCBs.
    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
    [board.brd, board.sch, sensor.brd, sensor.sch]
2012-03-18 Added preamp module for squaring waves
    A pre-amplificator module was added, so that one can use the timecode
    signal from some DVS CDs or vinyls.
    They are always encoded as amplitude-modulated sine/cos waves, so that it
    is always possible to square the waves and obtain a 2-bits incremental
    encoder signal, provided that the volume is reasonable.
    A red LED will signal to the user that the signal amplitude is not enough
    to read quadrature encoder signal, or simpli that the CD/vinyl is paused.
    TODO: add a double RCA connector for inputs.
    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
    [preamp.brd, preamp.sch]
2012-03-18 WIP: Improving debug messages
    The debug console is being improved to reduce the footprint (by using
    preprocessor definitions) and the overall performance.
    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
    [board.brd, board.sch]
2012-03-19 Improved debug console and interrupts
    The debug console should now work with nested interrupts.
    Global interrupts are now controllable with global macros defined in
    "app.h".
    The debug console function synthesis can be switched on or off, through
    configuration definitions.
    Inside the debug code, the user can choose to compile strings, integral
    types and constants, by defining USE_DEBUG_* inside "debug.h". This will
    enable/disable that feature inside the whole project.
    When including the "debug.h" header file, the user can choose not to
    compile ANY of the debug console symbols, by overriding each of them with
    an empty definition, by declaring DONT_USE_DEBUG_COSOLE before importing
    the header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
2012-03-19 Added input protection resistor to preamp
    Ah input resistor was added to preamp inputs, so that short circuits of
    clamping diodes won't hurt the connected device outputs.
    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
    [preamp.brd, preamp.sch]
2012-03-19 Improved interrupt handling
    Added a better locking system, which locks only "tasks" with priority
    higher than the lock caller. In this way, things such nested console
    prints should not give incorrect output strings.
    Incremental encoder interrupts are temporarily disabled (WIP), because
    they currently block the execution someway.
    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
2012-03-19 Fixed problems with encoder interrupts
    Priorities assigned to incremental encoder interrupts.
    Fixed swapped old/new encoder state in increment detection.
    Other small changes.
    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
    [adns2080.c, app.c, incenc.c, incenc.h, leds.c, leds.h]
2012-03-20 Better tracking of encoder state
    The incremental encoder state now tracks direction and its records have
    been refactored in order to support the right data type.
    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
2012-03-20 Fixed invalid encoder states
    Invalid encoder states won't do anything.
    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
    [incenc.c]
2012-03-20 HID report generation and other fixes
    The HID report generation is now done inside the application module.
    A timestamp function is tracked by USB SOF (1ms period).
    Locking functions are bare interrupt switches as before, the priority
    tracking was logically redundant.
    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
    [app.c, app.h, debug.h]
2012-03-20 Encoder interrupts fixed
    The incremental encoder interrupts are now working correctly. The flags
    and the internal lateches weren't handled the right way.
    Added a small delay in the main task for visualization purposes only. It
    will be removed in the future.
    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
    [app.c, incenc.c]
2012-03-21 Added double RCA connector to preamp module
    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
    [preamp.brd, preamp.sch]
2012-03-21 Trimmable preamp positive reference
    The preamp positive voltage reference is now trimmable, so that it can be
    calibrated in order to reduce misalignments with the main board's internal
    reference (internal DAC output of the PIC).
    Preamp board schematics refactored.
    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
    [preamp.brd, preamp.sch]
2012-03-22 Window comparator for preamp calibration
    The positive voltage reference for opamps is now reduced to a simple
    potentiometer, sithout impedance decoupling (not strictly needed).
    Two opamps are used as comparators for windowing of the rectified input
    signals. This way it is possible to warn the user if the signal is too low
    like before (bad comparator results) and also if the signal is too strong,
    thus leading to a potentially wring duty cycle of the squared wave.
    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
    [preamp.brd, preamp.sch]
2012-03-22 Minor changes
    Some comment lines were modified, and some switches are kept enabled.
    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
2012-03-27 USB descriptor and small changes
    The USB descriptor has the temporary VID/PID = 0xDEAD/0xBEEF.
    Strings have been changed, too.
    Small fixes for LED and debugging.
    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
    [adns2080.c, app.c, debug.c, debug.h]
2012-04-26 Code and comments refactoring
    Some code was moved so that readability and functions are better suited
    for the purpose.
    Most of the line Doxygen comments were modified from "///" to "///<", so
    that syntax rules apply correctly.
    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
    [adns2080.c, adns2080.h, app.c, app.h, debug.h, incenc.c, incenc.h, leds.h]
2012-05-18 Report introduction, optical encoders description
    Added the report introduction.
    Optical jogwheels described.
    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
2012-05-21 Schematics exported to PDF
    The schematics and board previews were exported into PDF format for
    documentation purposes.
    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
2012-05-21 Added some sensor documentation
    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
2012-07-30 Device library behavior and interrupt changes
    The device API was changed so that the incremental encoder and the mouse
    sensor status are cached into global variables, instead of passing values
    by function calls, since there are not multiple instances of such devices.
    This improves performance and optimizes memory usage.
    It is now possible to choose if the mouse sensor code reacts to interrupts
    or polls the status. Since the interrupt is simply cached and just wastes
    ISR code, it is a better idea to poll it just before building the HID
    report.
    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
2012-07-30 Sensor performance not forced anymore
    Even tough it sounds strange, sensor performance is better if not always
    forced to the maximum. In fact, when forced it loses accuracy with small
    motions, which should be the main objective of the project.
    Not forcing performance settings makes the sensor highly reactive to the
    smallest movements, and automatically adjusts the performance when the
    motion is detected. The built-in algorithm works betetr than expected!
    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
2012-07-30 Motion interrupt enabled again
    The motion interrupt was enabled again, until a stable polling method is
    developed. Currently, polling the MOTION pin always returns a low value,
    while it should give it only when there is actually new data.
    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
2012-07-31 Fixed issues with motion polling
    Motion pin polling now works properly. Since everything is done inside the
    ADNS service routine, the interrupt is pretty useless, while polling is an
    effective method, and doesn't waste ISR cycles.
    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
    [adns2080.c, adns2080.h, app.c]
2012-07-31 Fixed HID report size
    The HID report size is now equal to the actual meaningful data contained.
    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
    [app.c]
2012-08-01 Some encoder tweaks
    The mouse sensor is now forced to 2000 DPI.
    The incremental encoder now correctly reads a quadrature signal derived
    from a common DVS timecode.
    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
    [adns2080.c, app.c, app.h, incenc.c, incenc.h]
2012-08-04 Updated schematics to Eagle 6.2.0
    Schematic project files were updated to Eagle 6.2.0.
    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
2012-08-04 Motion accumulator inverted
    The mouse motion deltas are now subtracted to the accumulator. This lets
    the user to put the RATT device on the top of a turntable.
    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
    [app.c]
2012-08-04 Fixed figure numbering and more
    Numbering inside the LaTeX document now works properly.
    An example of button matrix figure was added.
    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
2012-08-06 Incremental encoder sign changed
    Sign changed back to be coherent with quadrature wave. It has still to be
    verified with electrical schematics.
    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
2012-08-07 Documentation structure reworked
    The appendices of the documentation were moved after the current market
    survey.
    The I2C bus descritption was removed, because actually no mouse sensors
    use it.
    Small fixes.
    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
2012-08-08 Added Virtual DJ mapping documentation
    The Virtual DJ device description and its mapping were added to the
    documentation.
    Other small fixed.
    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
2012-08-10 Small fixes
    Small fixes in the definition and use of the HID report.
    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
    [app.c]
2012-08-10 Added HID Trace and bootloader host application
    Added the HID Trace tool by Atomix Productions. It is a very simple tool
    to trace USB data being transferred by HID devices.
    Added alto the bootloader host application, used to load the compiled HEX
    program on the PIC18LF14K50.
    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
2012-08-12 Added computations spreadsheet
    A spreadsheet for computations was added. It also simplifies the update of
    the report source code, with computation data.
    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
    [computations.xls]
2012-08-12 Added computations description
    Computations for the mouse sensor sizing and proofs are now documented.
    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
2012-08-12 Added MOTION delay screenshots
    Oscilloscope screenshots for MOTION interrupt delays for slow and fast
    motions were added.
    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
2012-08-12 Report sources moved
    The documentation (report) sources were moved into the /src directory.
    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
    [computations.xls]
2012-08-13 Added placement picture and small fixes
    A picture representing the RATT displacement over a vinyl was added.
    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
    [computations.xls]
2012-08-13 Added XML files for Virtual DJ
    Device and mapping XML files for Virtual DJ were added. Also, some scripts
    automate the installation of such files on both Windows and MacOSX (Unix).
    Small changes.
    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
2012-08-14 Added firmware framework and ADNS-3550 pictures
    A logical view of the firmware framework was added to the simplified
    approach documentation.
    An alternative sensor, the Avago ADNS-3550, was proposed in the advanced
    approach.
    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
2012-08-14 Added report schematics sources
    Eagle sources of the report schematic examples were added to the
    repository.
    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
    [keypad.sch, midi_in.sch, midi_out.sch, pots_mcu.sch]
2012-08-19 Updated advanced framework picture
    Some modules were missing, and are now present.
    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
2012-09-01 Computations updated
    Computations for the measurement perimeter dots were updated.
    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
    [computations.xls]
